MarJong/ECCO-Uhr/Fertigungsdaten/Adapterplatine V1_0.png

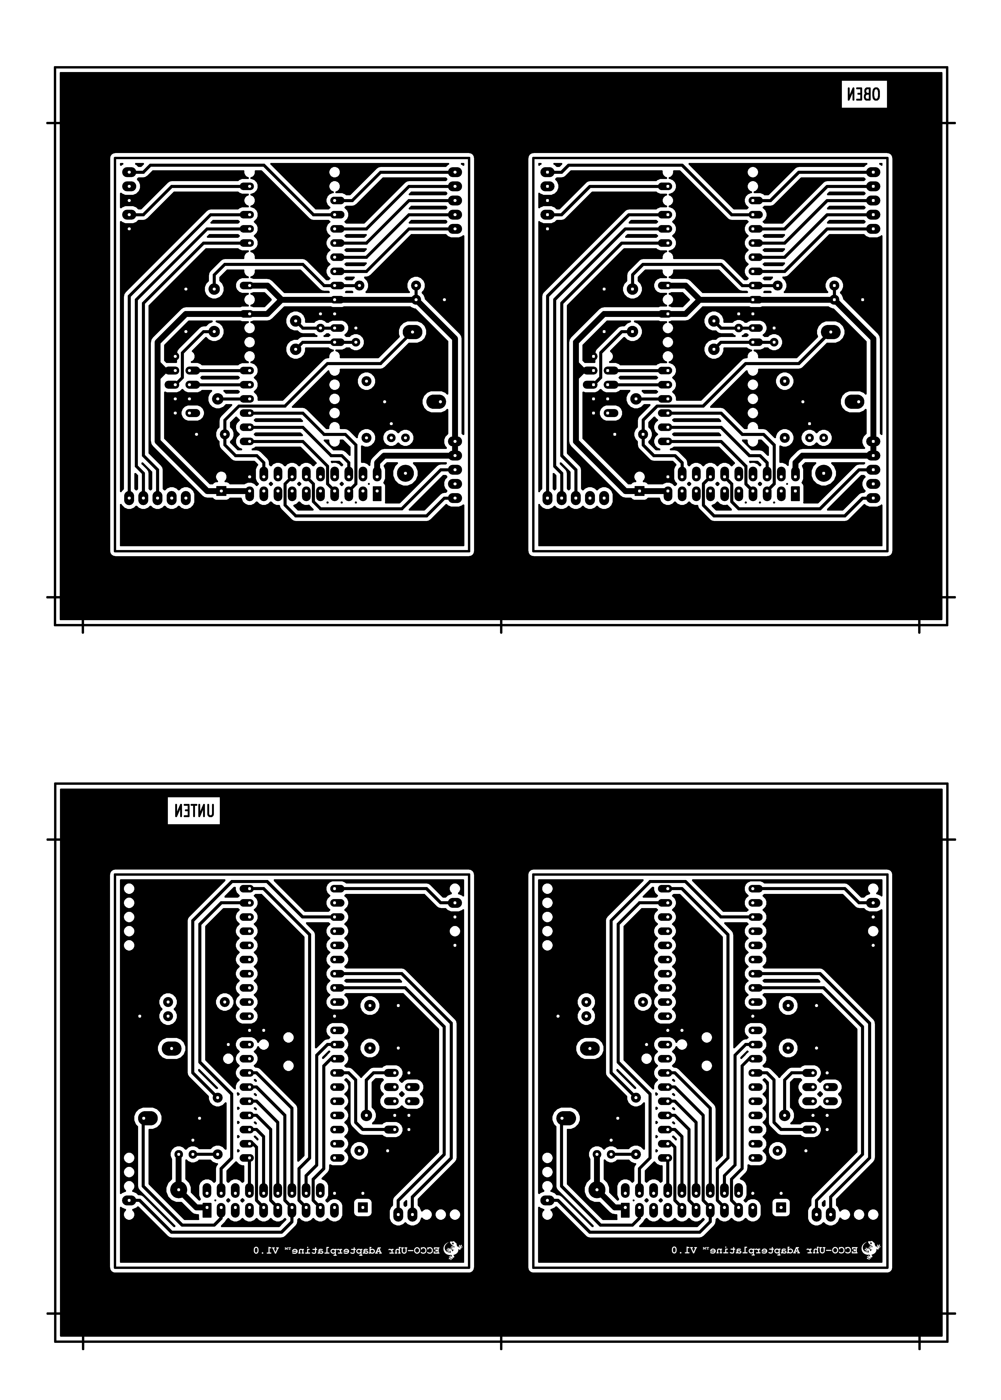
Fertigungsdaten/Adapterplatine V1_0.png
