MarJong/ECCO-Uhr/Fertigungsdaten/Bestueckung_Hauptplatine.png

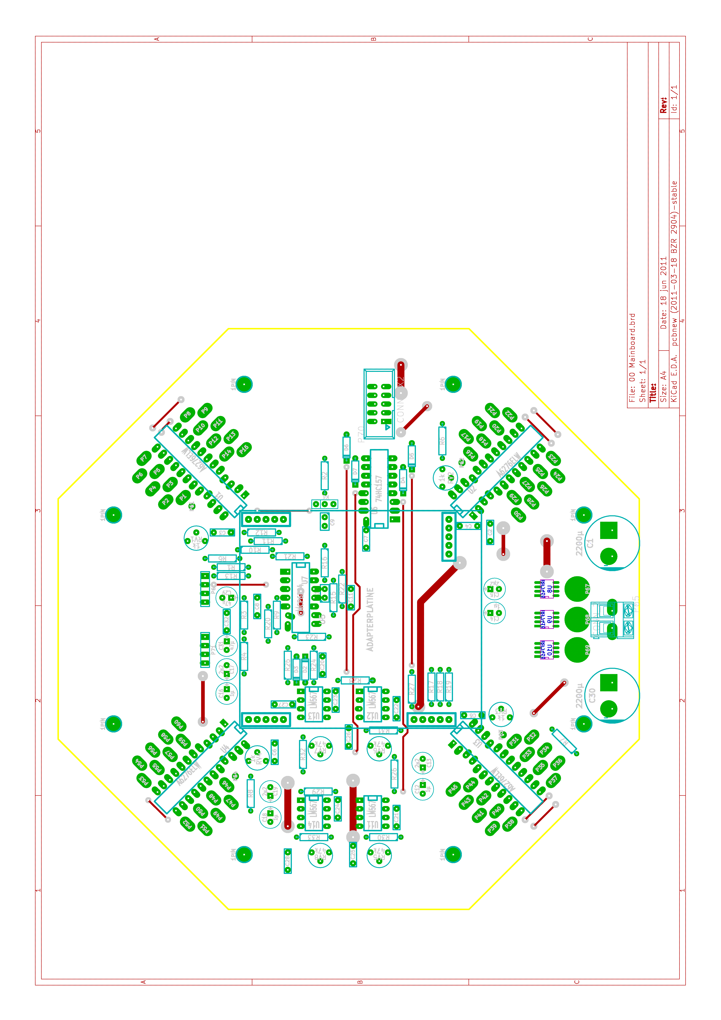
Fertigungsdaten/Bestueckung_Hauptplatine.png
