MarJong/ECCO-Uhr/Fertigungsdaten/Pinbelegung_Adapterplatine.png

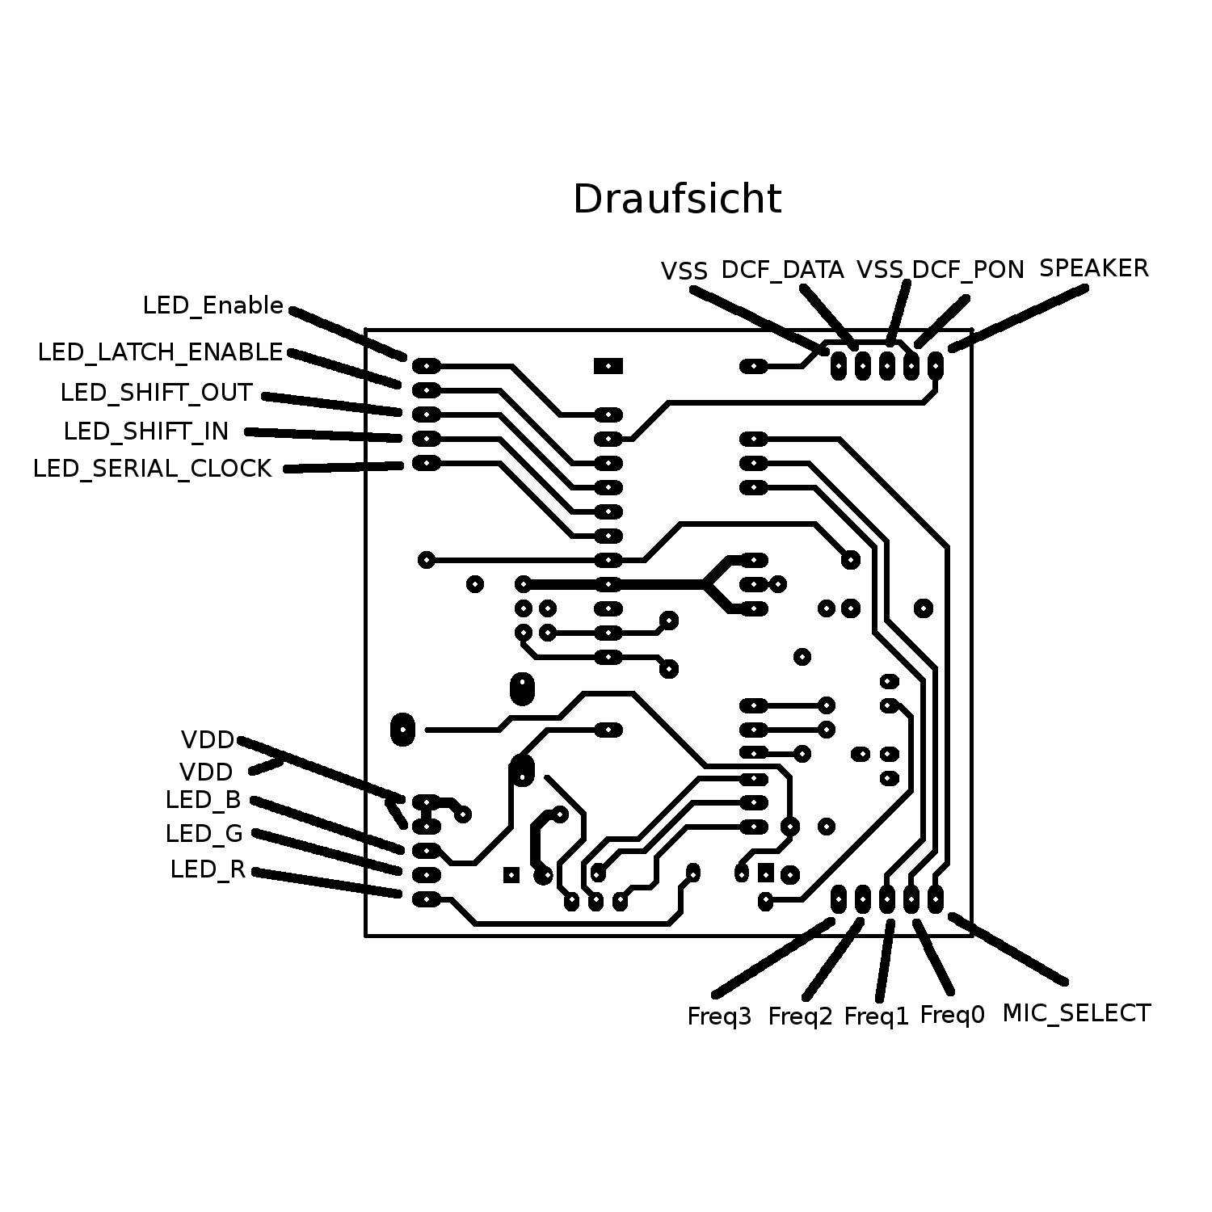
Fertigungsdaten/Pinbelegung_Adapterplatine.png
