MarJong/ECCO-Uhr/Fertigungsdaten/Pinbelegung_Mainboard.png

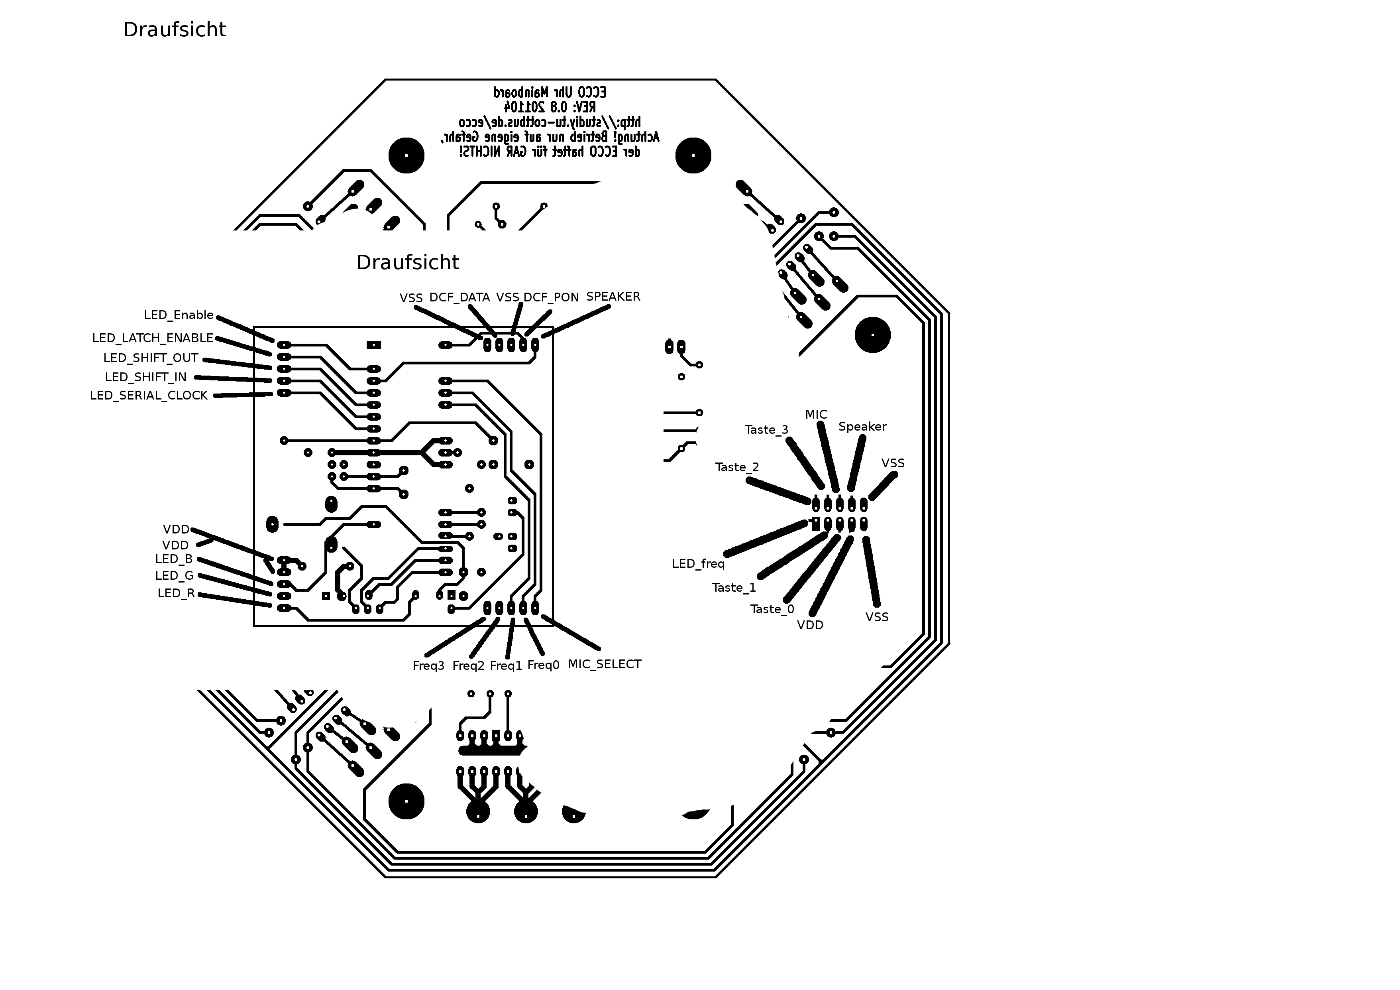
Fertigungsdaten/Pinbelegung_Mainboard.png
