MarJong/ECCO-Uhr/Fertigungsdaten/Schablone_Mainboard_V1.png

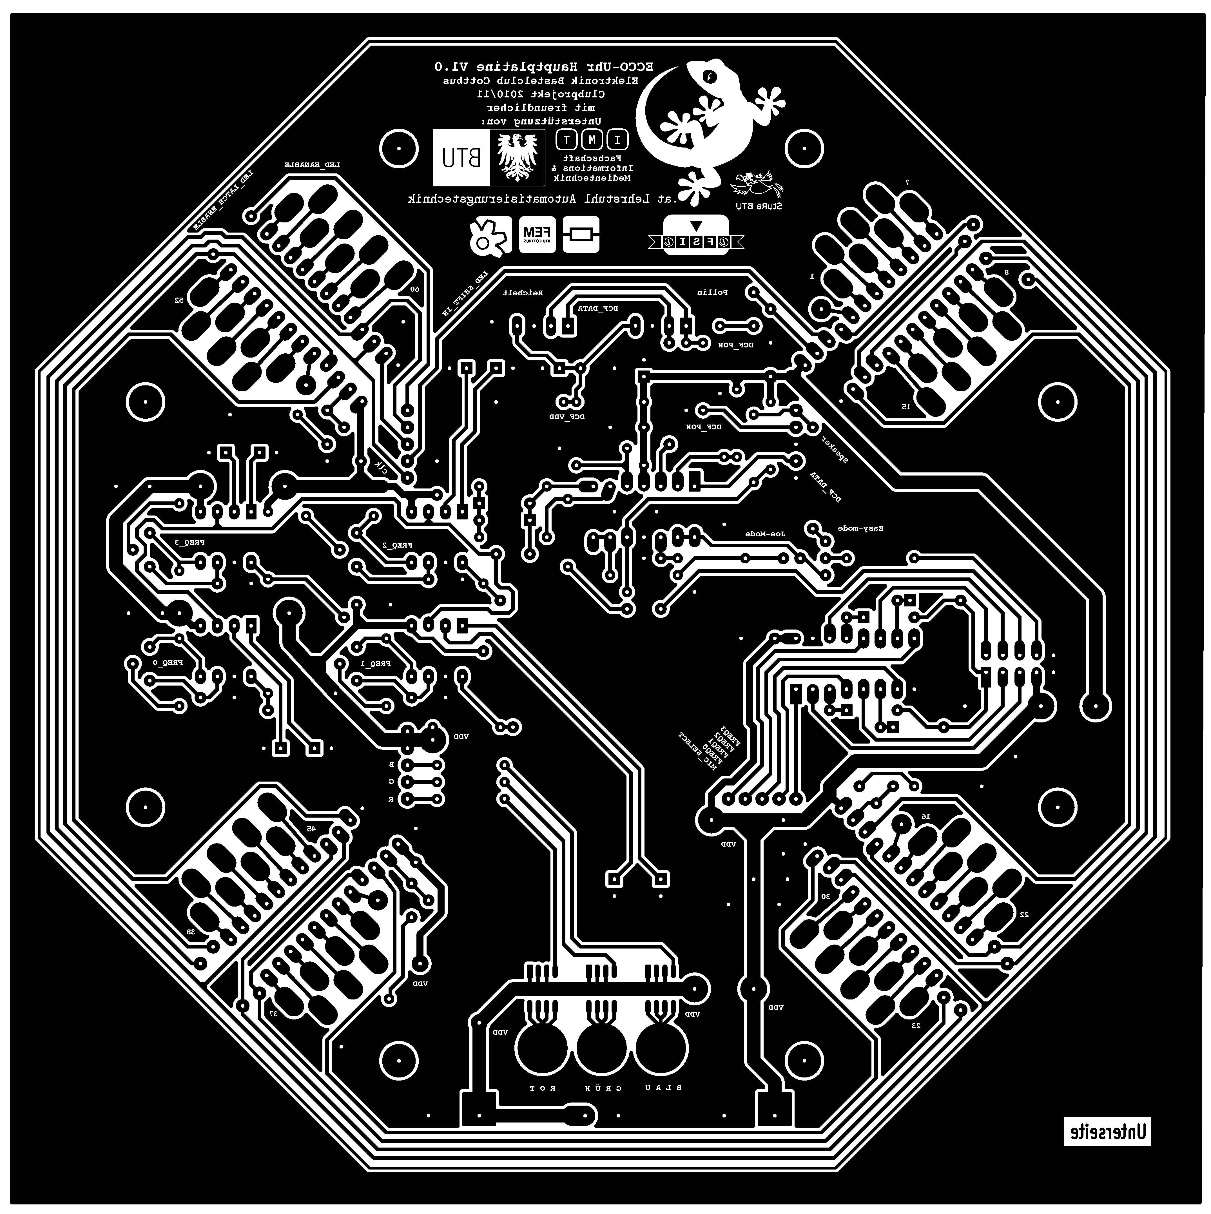
Fertigungsdaten/Schablone_Mainboard_V1.png
