MarJong/ECCO-Uhr/Fertigungsdaten/Schematic_Adapterplatine.png

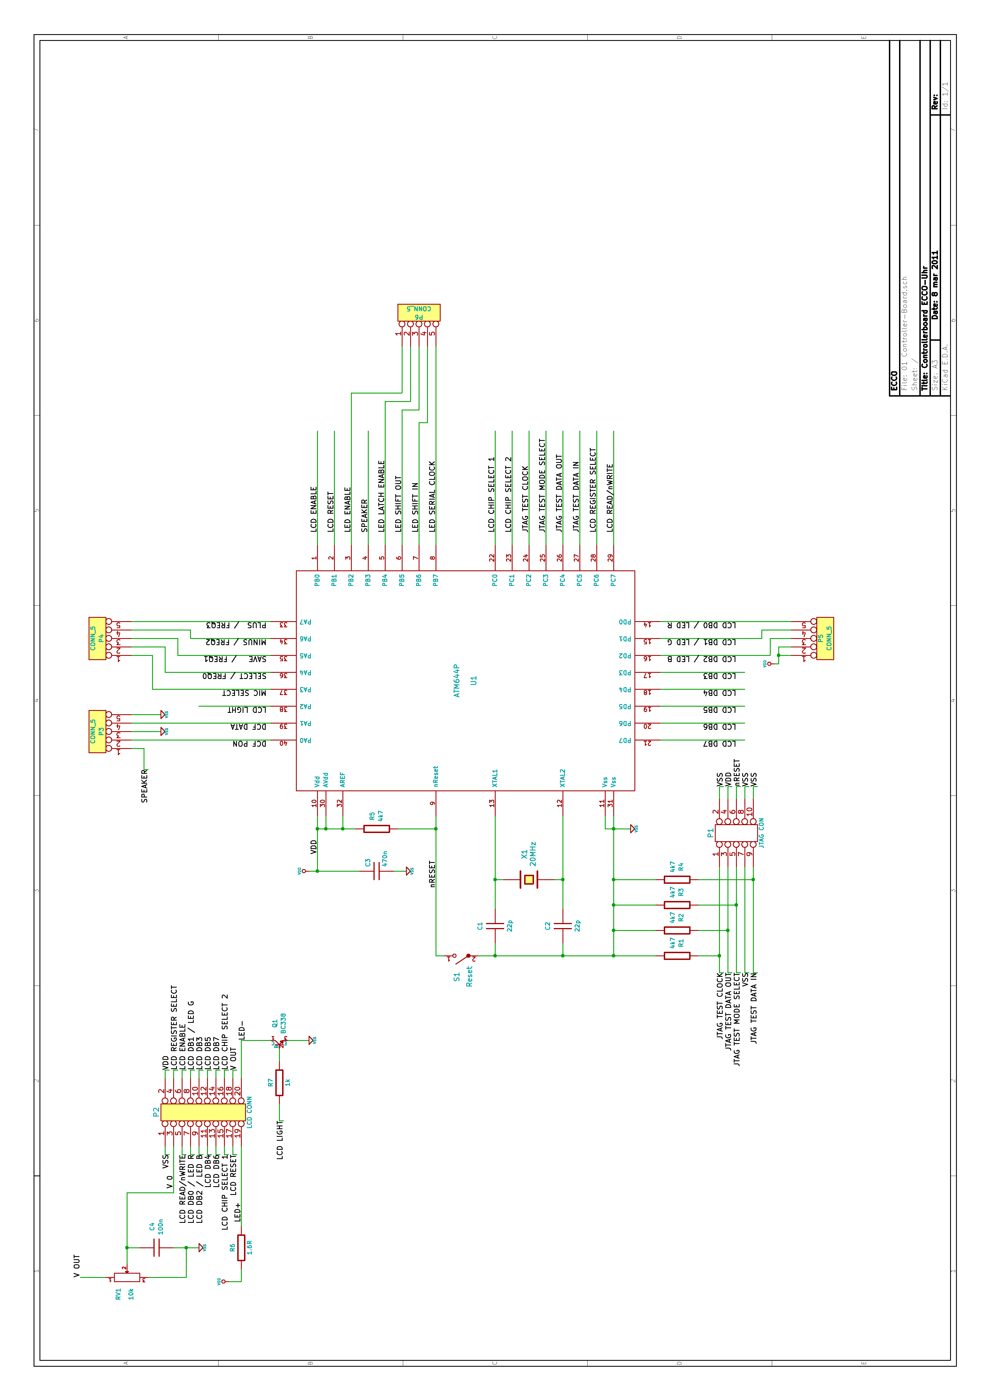
Fertigungsdaten/Schematic_Adapterplatine.png
