MarJong/ECCO-Uhr/Fertigungsdaten/Schematic_IOPlatine.png

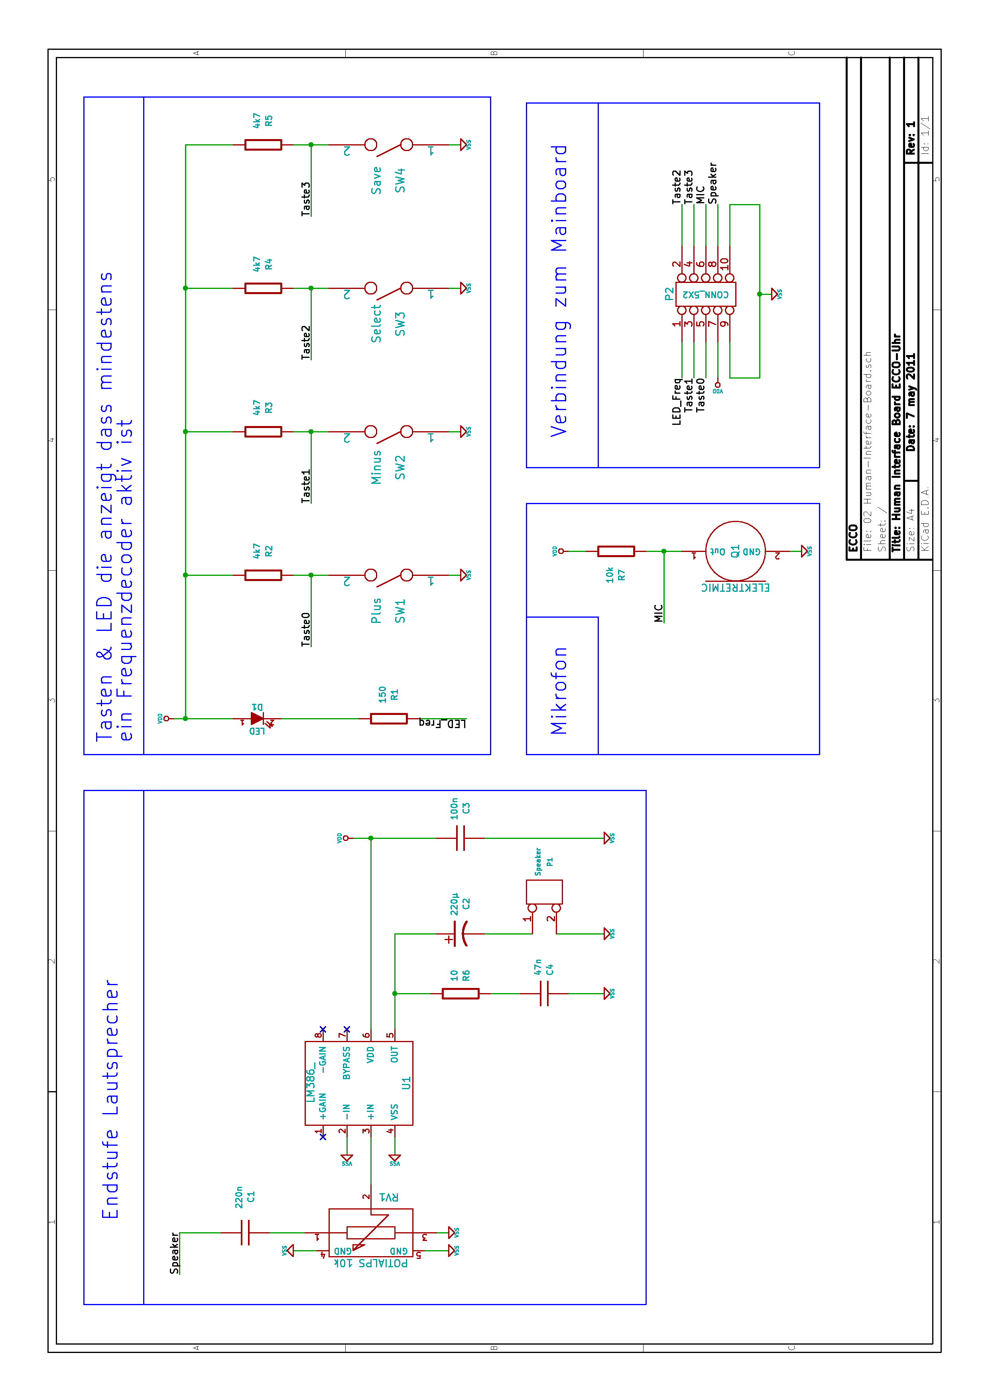
Fertigungsdaten/Schematic_IOPlatine.png
