MarJong/ECCO-Uhr/Fertigungsdaten/Schematic_Mainboard.png

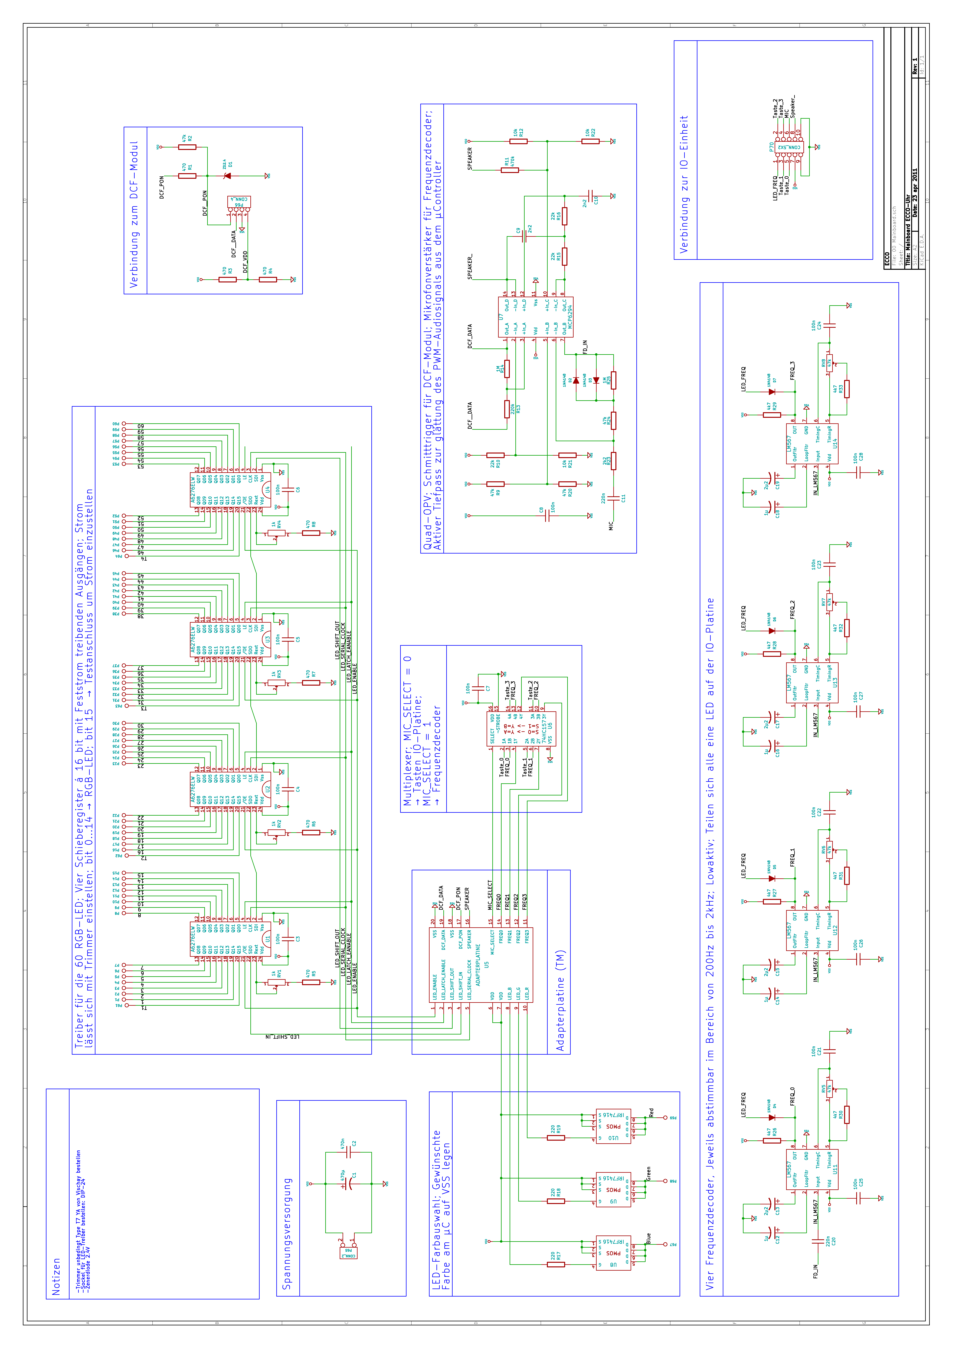
Fertigungsdaten/Schematic_Mainboard.png
