MarJong/ECCO-Uhr/Fertigungsdaten/Sponsoren.png

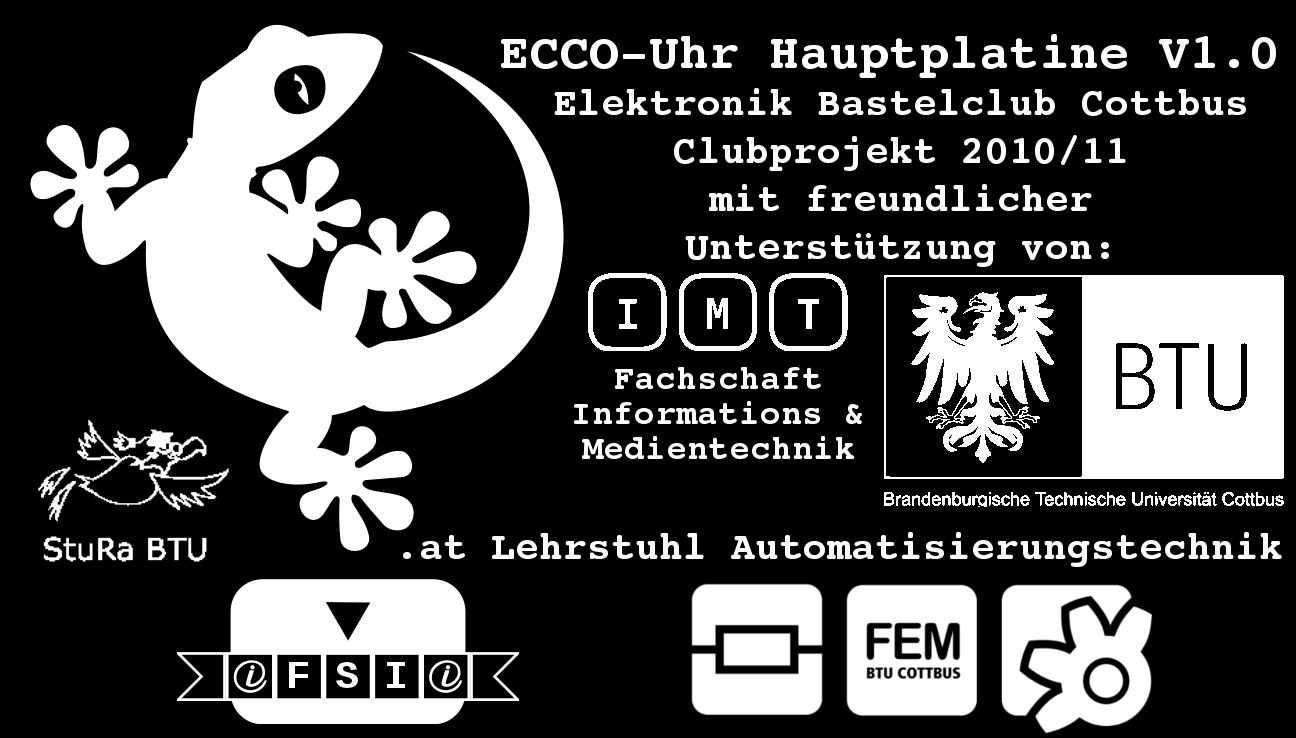
Fertigungsdaten/Sponsoren.png
