MarJong/ECCO-Uhr/Hardware/00 Mainboard-Back.png

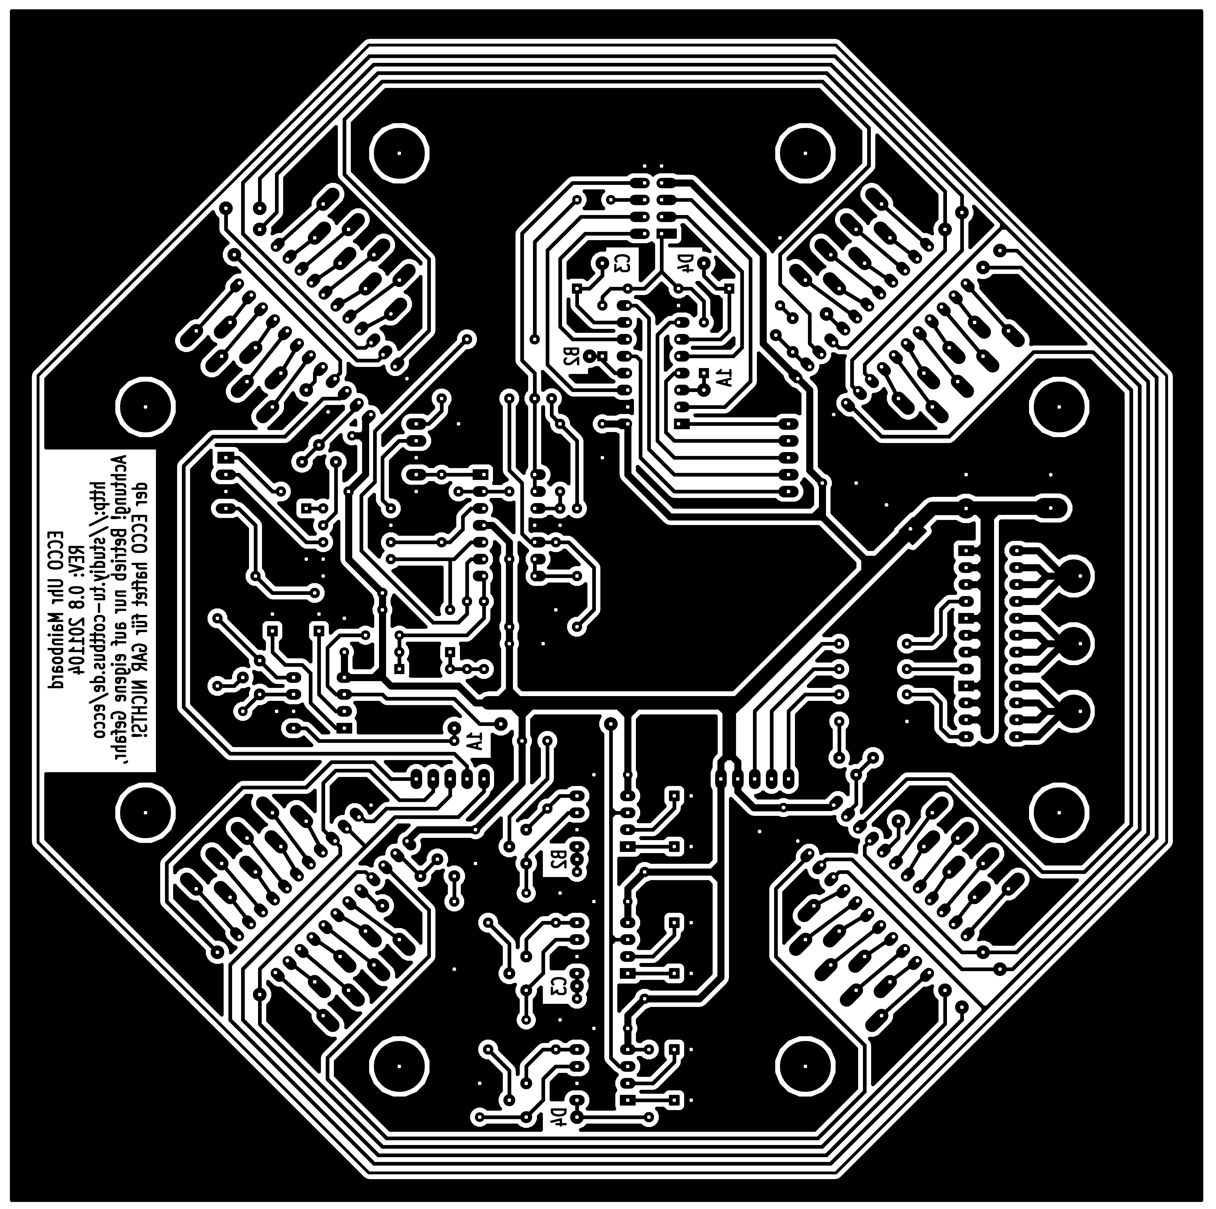
Hardware/00 Mainboard-Back.png
