MarJong/ECCO-Uhr/Hardware/00 Mainboard.png

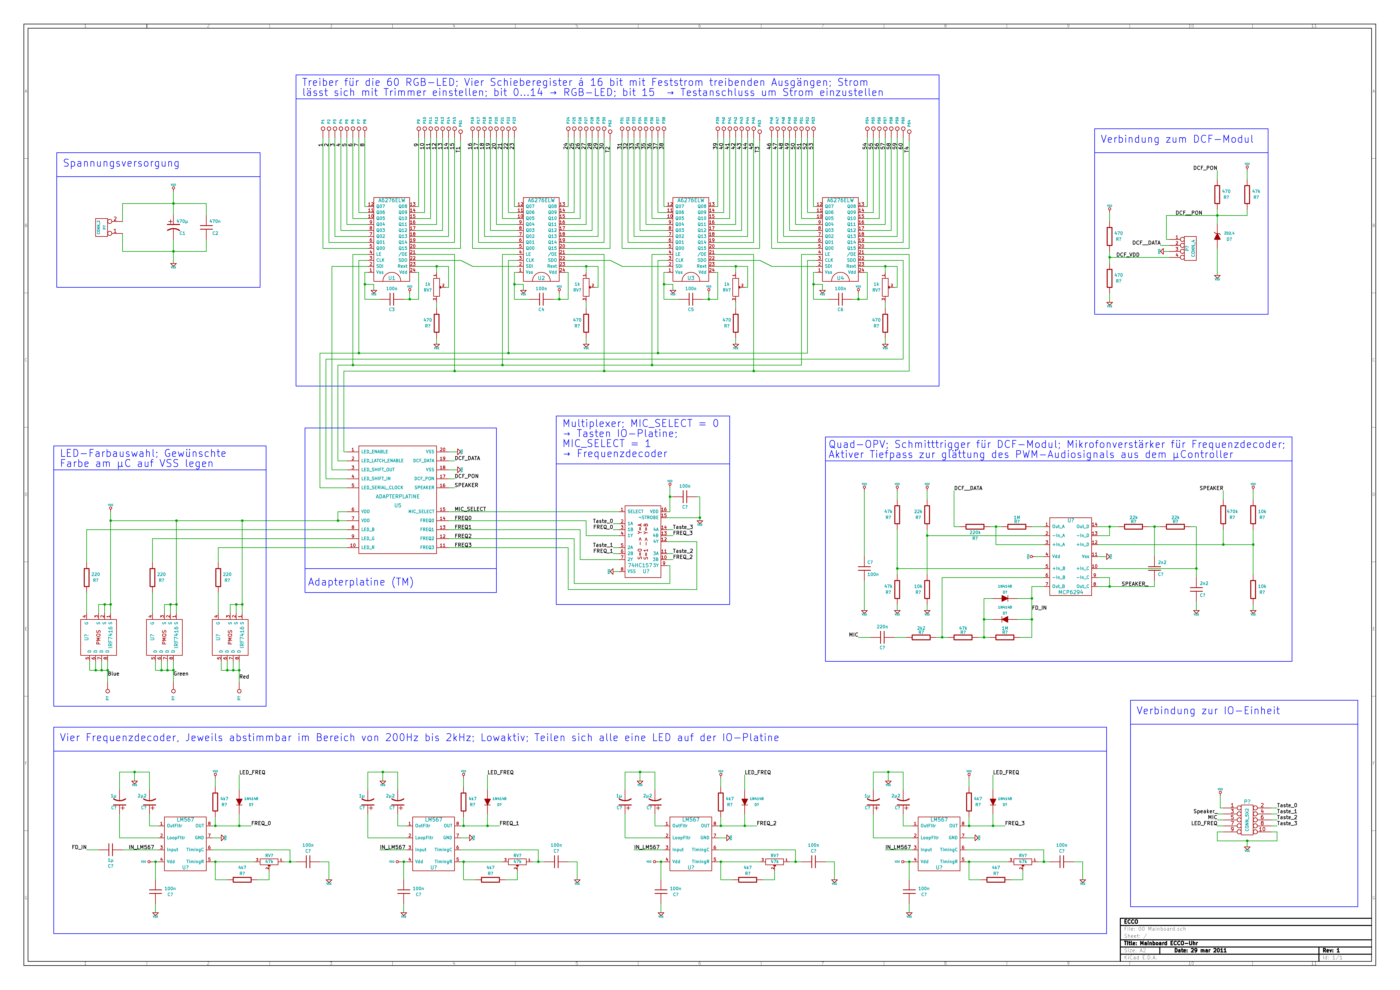
Hardware/00 Mainboard.png
