MarJong/ECCO-Uhr/Hardware/03 LED-Boards-Back.png

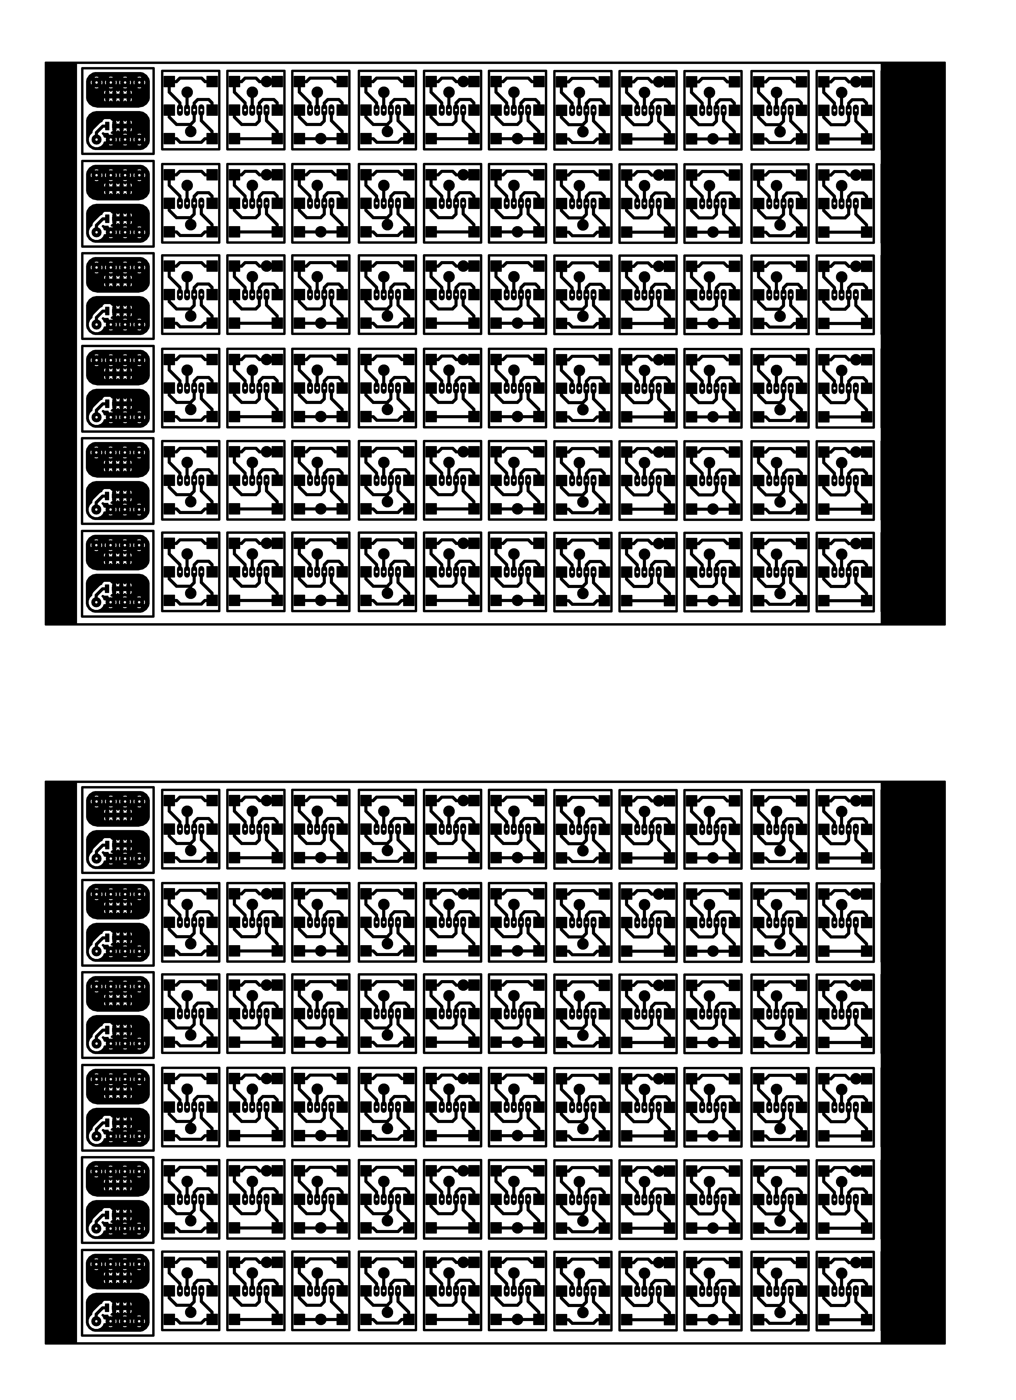
Hardware/03 LED-Boards-Back.png
