MarJong/ECCO-Uhr/Hardware/00 Mainboard Stückliste.pdf

Tabelle1

ref | value | footprint | Verfügbarkeit | Erledigt
C1 | 470µ | 5.08mm
C2 | 470n | 5.08mm
C3 | 100n | 5.08mm
C4 | 100n | 5.08mm
C5 | 100n | 5.08mm
C6 | 100n | 5.08mm
C7 | 100n | 5.08mm
C8 | 100n | 5.08mm
C9 | 2n2 | 2.54mm
C10 | 2n2 | 2.54mm
C11 | 220n | 5.08mm
C12 | 1µ | 5.08mm
C13 | 2µ2 | 2.54mm
C14 | 1µ | 2.54mm
C15 | 2µ2 | 2.54mm
C16 | 1µ | 5.54mm
C17 | 2µ2 | 5.54mm
C18 | 1µ | 5.54mm
C19 | 2µ2 | 5.54mm
C20 | 1µ | 5.54mm
C21 | 100n | 5.08mm
C22 | 100n | 5.08mm
C23 | 100n | 5.08mm
C24 | 100n | 5.08mm
C25 | 100n | 5.08mm
C26 | 100n | 5.08mm
C27 | 100n | 5.08mm
C28 | 100n | 5.08mm
D1 | ZD2.4 | DO-35
D2 | 1N4148 | DO-34
D3 | 1N4148 | DO-33
D4 | 1N4148 | DO-32
D5 | 1N4148 | DO-31
D6 | 1N4148 | DO-30
D7 | 1N4148 | DO-29
P61 | CONN_1 | Lötnagel
P62 | CONN_1 | Lötnagel
P63 | CONN_1 | Lötnagel
P64 | CONN_1 | Lötnagel
P65 | CONN_2 | AKL 5,08mm
P66 | CONN_4 | Buchsenleiste
P70 | CONN_5X2 | Wannenstecker gerade
R1 | 470 | Metall 0.6W
R2 | 47k | Metall 0.6W
R3 | 470 | Metall 0.6W
R4 | 470 | Metall 0.6W
R5 | 470 | Metall 0.6W
R6 | 470 | Metall 0.6W
R7 | 470 | Metall 0.6W

Tabelle1

ref | value | footprint | Verfügbarkeit | Erledigt
R8 | 470 | Metall 0.6W
R9 | 47k | Metall 0.6W
R10 | 22k | Metall 0.6W
R11 | 470k | Metall 0.6W
R12 | 10k | Metall 0.6W
R13 | 220k | Metall 0.6W
R14 | 1M | Metall 0.6W
R15 | 22k | Metall 0.6W
R16 | 22k | Metall 0.6W
R17 | 220 | Metall 0.6W
R18 | 220 | Metall 0.6W
R19 | 220 | Metall 0.6W
R20 | 47k | Metall 0.6W
R21 | 10k | Metall 0.6W
R22 | 10k | Metall 0.6W
R23 | 2k2 | Metall 0.6W
R24 | 47k | Metall 0.6W
R25 | 1M | Metall 0.6W
R26 | 4k7 | Metall 0.6W
R27 | 4k7 | Metall 0.6W
R28 | 4k7 | Metall 0.6W
R29 | 4k7 | Metall 0.6W
R30 | 4k7 | Metall 0.6W
R31 | 4k7 | Metall 0.6W
R32 | 4k7 | Metall 0.6W
R33 | 4k7 | Metall 0.6W
RV1 | 1k | Metall 0.6W
RV2 | 1k | Metall 0.6W
RV3 | 1k | Metall 0.6W
RV4 | 1k | Metall 0.6W
RV5 | 47k | Metall 0.6W
RV6 | 47k | Metall 0.6W
RV7 | 47k | Metall 0.6W
RV8 | 47k | Metall 0.6W
U1 | A6276ELW | DIL-24
U2 | A6276ELW | DIL-24
U3 | A6276ELW | DIL-24
U4 | A6276ELW | DIL-24
U5 | ADAPTERPLATINE | 4*5er Buchsenleisten
U6 | 74HC157 | DIL-16
U7 | MCP6294 | DIL-14
U8 | IRF7416 | 2*12er Buchsenleisten
U9 | IRF7416
U10 | IRF7416
U11 | LM567 | DIL-8
U12 | LM567 | DIL-8
U13 | LM567 | DIL-8
U14 | LM567 | DIL-8
