MarJong/ECCO-Uhr/Fertigungsdaten/Materialbedarf_Mainboard.ods

 | Designator | Package | Qty | Designation | Verfügbar | Erledigt
0 | Platine (incl. Aller Brücken!) | 1,5mm Epoxid | 1 | Hauptplatine
1 | U8, U9, U10 | SO8E | 3 | IRF7416
2 | U11, U12, U13, U14 | DIP-8 | 4 | LM567 + Sockel
3 | U1, U2, U3, U4 | DIP-24 | 4 | A6276ELW + Sockel
4 | U6 | DIP-16 | 1 | 74HC157 + Sockel
5 | U7 | DIP-14 | 1 | MCP6294 + Sockel
6 | K1 | Stiftleiste + Jumper | 1 | CONN_3
7 | U5 | Adapterplatine_1.0 | 1 | 4*5er Buchsenleiste
8 | P61, P62, P63, P64 | Lötnagel | 7 | CONN_1
9 | P65 | AKL 5.08mm | 1 | CONN_2
10 | P70 | Wannenstecker 5*2 | 1 | CONN_5X2
11 | P66, P71 | Stiftleiste 4x1 | 1 | Reichelt, Pollin (DCF)
12 | RV1, RV2, RV3, RV4 | VISHAY T7YA | 4 | 1k
13 | RV5, RV6, RV7, RV8 | VISHAY T7YA | 4 | 47k
14 | R17, R18, R19 | 10.16mm | 3 | 220
15 | R3 | 10.16mm | 1 | 330
16 | R4, R5, R6, R7, R8 | 10.16mm | 5 | 470
17 | R23 | 10.16mm | 1 | 2k2
18 | R1 | 10.16mm | 1 | 3k3
19 | R13, R26, R27, R28, R29, R31 | 10.16mm | 6 | 4k7
20 | R12, R21, R22 | 10.16mm | 3 | 10k
21 | R10, R11, R15, R16, R30, R32, R33 | 10.16mm | 7 | 22k
22 | R9, R20, R24 | 10.16mm | 3 | 47k
24 | R2 | 10.16mm | 1 | 100k
25 | R25 | 10.16mm | 1 | 1M
26 | D2, D3, D4, D5, D6, D7 | 7.62mm | 6 | 1N4148
27 | C9, C10 | 2.54mm | 2 | 2n2
28 | C23, C24 | 5.08mm | 2 | 22n
29 | C21, C22 | 5.08mm | 2 | 47n
30 | C3, C4, C5, C6, C7, C8, C25, C26, C27, C28, C32 | 5.08mm | 11 | 100n
31 | C11 | 5.08mm | 1 | 220n
32 | C2 | 5.08mm | 1 | 470n
33 | C20 | 5.08mm | 1 | 1000n
34 | C12, C14, C16, C18 | 2.54mm | 4 | 1µ
35 | C13, C15, C17, C19 | 2.54mm | 4 | 2µ2
36 | C29, C31 | 2.54mm | 2 | 47µ
37 | C1, C30 | 7.62mm | 2 | 2200µ
38 | Schrauben & Abstandshalter | M3 | 8
