MarJong/ECCO-Uhr/Fertigungsdaten/AdapterplatineStueckliste.ods

Id | Designator | Package | Quantity | Designation | Vorhanden | Erledigt
1 | R1 | R4-LARGE_PADS | 1 | 1k
2 | P3 | Wanne_5x2_HM | 1 | JTAG_CON
3 | P1 | Wanne_10x2_HM | 1 | LCD_CONN
4 | Q1 | TO92-123 | 1 | BC338
5 | S1 | SW_PUSH_SMALL | 1 | Reset
6 | R2 | R4-LARGE_PADS | 1 | 4k7
7 | RV1 | PT15_HM_PIHER | 1 | 10k
8 | P4,P5,P6,P7 | pin_strip_5 | 4 | CONN_5
9 | X1 | HC-49V | 1 | 20MHz
10 | U1 | DIP-40__600_ELL | 1 | ATM644P
11 | C4 | CP_5x11mm | 1 | 100µ
12 | C1 | C2 | 1 | 100n
13 | C5 | C2 | 1 | 470n
14 | C2,C3 | C1 | 2 | 22p
