MarJong/ECCO-Uhr/Hardware/01 Controller-Board-stückliste.ods

ref | value
C1 | 22p
C2 | 22p
C3 | 470n
C4 | 100n
P1 | JTAG CON
P2 | LCD CONN
P3 | CONN_5
P4 | CONN_5
P5 | CONN_5
P6 | CONN_5
Q1 | BC338
R1 | 4k7
R2 | 4k7
R3 | 4k7
R4 | 4k7
R5 | 4k7
R6 | 1.6R
R7 | 1k
RV1 | 10k
S1 | Reset
U1 | ATM644P
X1 | 20MHz
