MarJong/ECCO-Uhr/Hardware/00 Mainboard.ods

Id | Designator | Package | Quantity | Designation | Supplier and ref
1 | P69,P68,P67,P61,P64,P63,P62 | 1pin | 7 | CONN_1
2 | P65 | AK300-2 | 1 | CONN_2
3 | C10,C9 | C1 | 2 | 2n2
4 | C19,C17,C15,C13 | C1V7 | 4 | 2µ2
5 | C18,C16,C14,C12 | C1V7 | 4 | 1µ
6 | C28,C27,C26,C25,C24,C23,C22,C21,C8,C7,C6,C5,C4,C3 | C2 | 14 | 100n
7 | C11,C20 | C2 | 2 | 220n
8 | C2 | C2 | 1 | 470n
9 | D7,D6,D5,D4,D3,D2 | D3 | 6 | 1N4148
10 | D1 | D3 | 1 | ZD2.4
11 | U7 | DIP-14__300_ELL | 1 | MCP6294
12 | U6 | DIP-16__300_ELL | 1 | 74HC157
13 | U4,U3,U2,U1 | DIP-24__300_ELL | 4 | A6276ELW
14 | U14,U13,U12,U11 | DIP-8__300_ELL | 4 | LM567
15 | U10,U9,U8 | DIP-8__300_ELL | 3 | IRF7416
16 | P66 | PIN_ARRAY_4x1 | 1 | CONN_4
17 | RV8,RV7,RV6,RV5 | RV2 | 4 | 47k
18 | RV4,RV3,RV2,RV1 | RV2 | 4 | 1k
19 | P70 | VASCH5x2 | 1 | CONN_5X2
20 | U5 | Adapterplatine_0.9 | 1 | ADAPTERPLATINE
21 | P1...P60 | 1pin_smd | 60 | CONN_1
22 | C1 | C2V10 | 1 | 470µ
23 | R7,R8,R5,R6,R1,R4,R3 | R4 | 7 | 470
24 | R19,R18,R17 | R4 | 3 | 220
25 | R14,R25 | R4 | 2 | 1M
26 | R13 | R4 | 1 | 220k
27 | R15,R16,R10 | R4 | 3 | 22k
28 | R22,R12,R21 | R4 | 3 | 10k
29 | R11 | R4 | 1 | 470k
30 | R24,R20,R9,R2 | R4 | 4 | 47k
31 | R30,R26,R27,R31,R28,R32,R29,R33 | R4 | 8 | 4k7
32 | R23 | R4 | 1 | 2k2
33 | 1PIN,1PIN,1PIN,1PIN,1PIN,1PIN,1PIN,1PIN | 1pin | 8 | P***
