MarJong/ECCO-Uhr/Fertigungsdaten/Frontplatte_A3.pdf

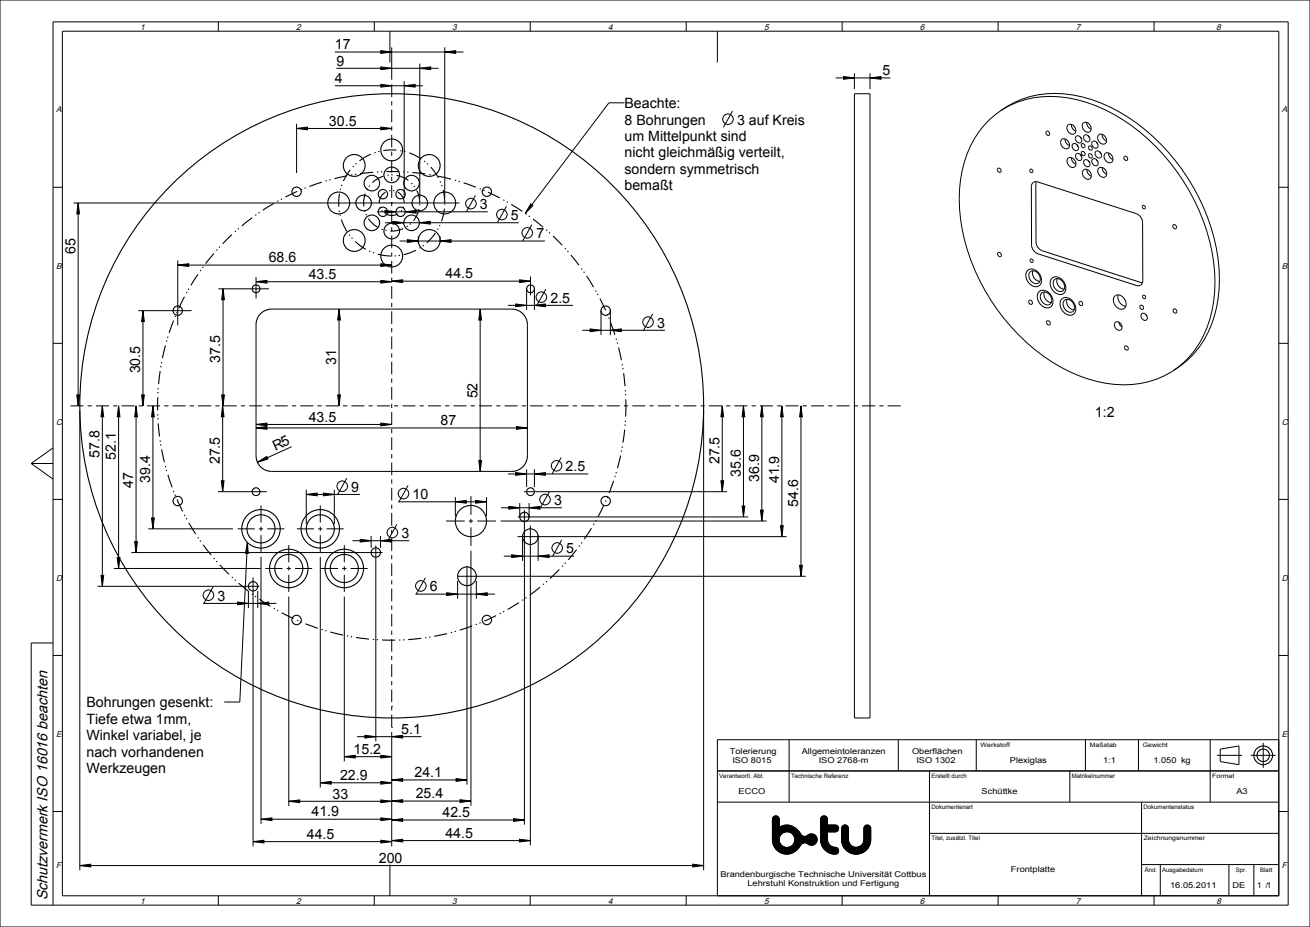
[picture p13: page 1]
Dokumentenart; Dokumentenstatus; 8 Bohrungen; 3 auf Kreis

Beachte:
um Mittelpunkt sind
nicht gleichmäßig verteilt,
sondern symmetrisch
bemaßt

Schutzvermerk ISO 16016 beachten
Bohrungen gesenkt:
Tiefe etwa 1mm,
Winkel variabel, je
nach vorhandenen
Werkzeugen

Tolerierung ISO 8015 | Allgemeintoleranzen ISO 2768-m | Oberflächen ISO 1302 | Werkstoff Plexiglas | Maßstab 1:1 | Gewicht 1.050 kg

Verantwortl. Abt. ECCO | Technische Referenz | Erstellt durch Schüttke | Matrikelnummer | Format A3

Titel, zusätzl. Titel Frontplatte Brandenburgische Technische Universität Cottbus | Zeichnungsnummer

Änd. | Ausgabedatum 16.05.2011 | Spr. DE | Blatt 1 /1

Lehrstuhl Konstruktion und Fertigung
