MarJong/ECCO-Uhr/Fertigungsdaten/frontplatte_einfach.pdf

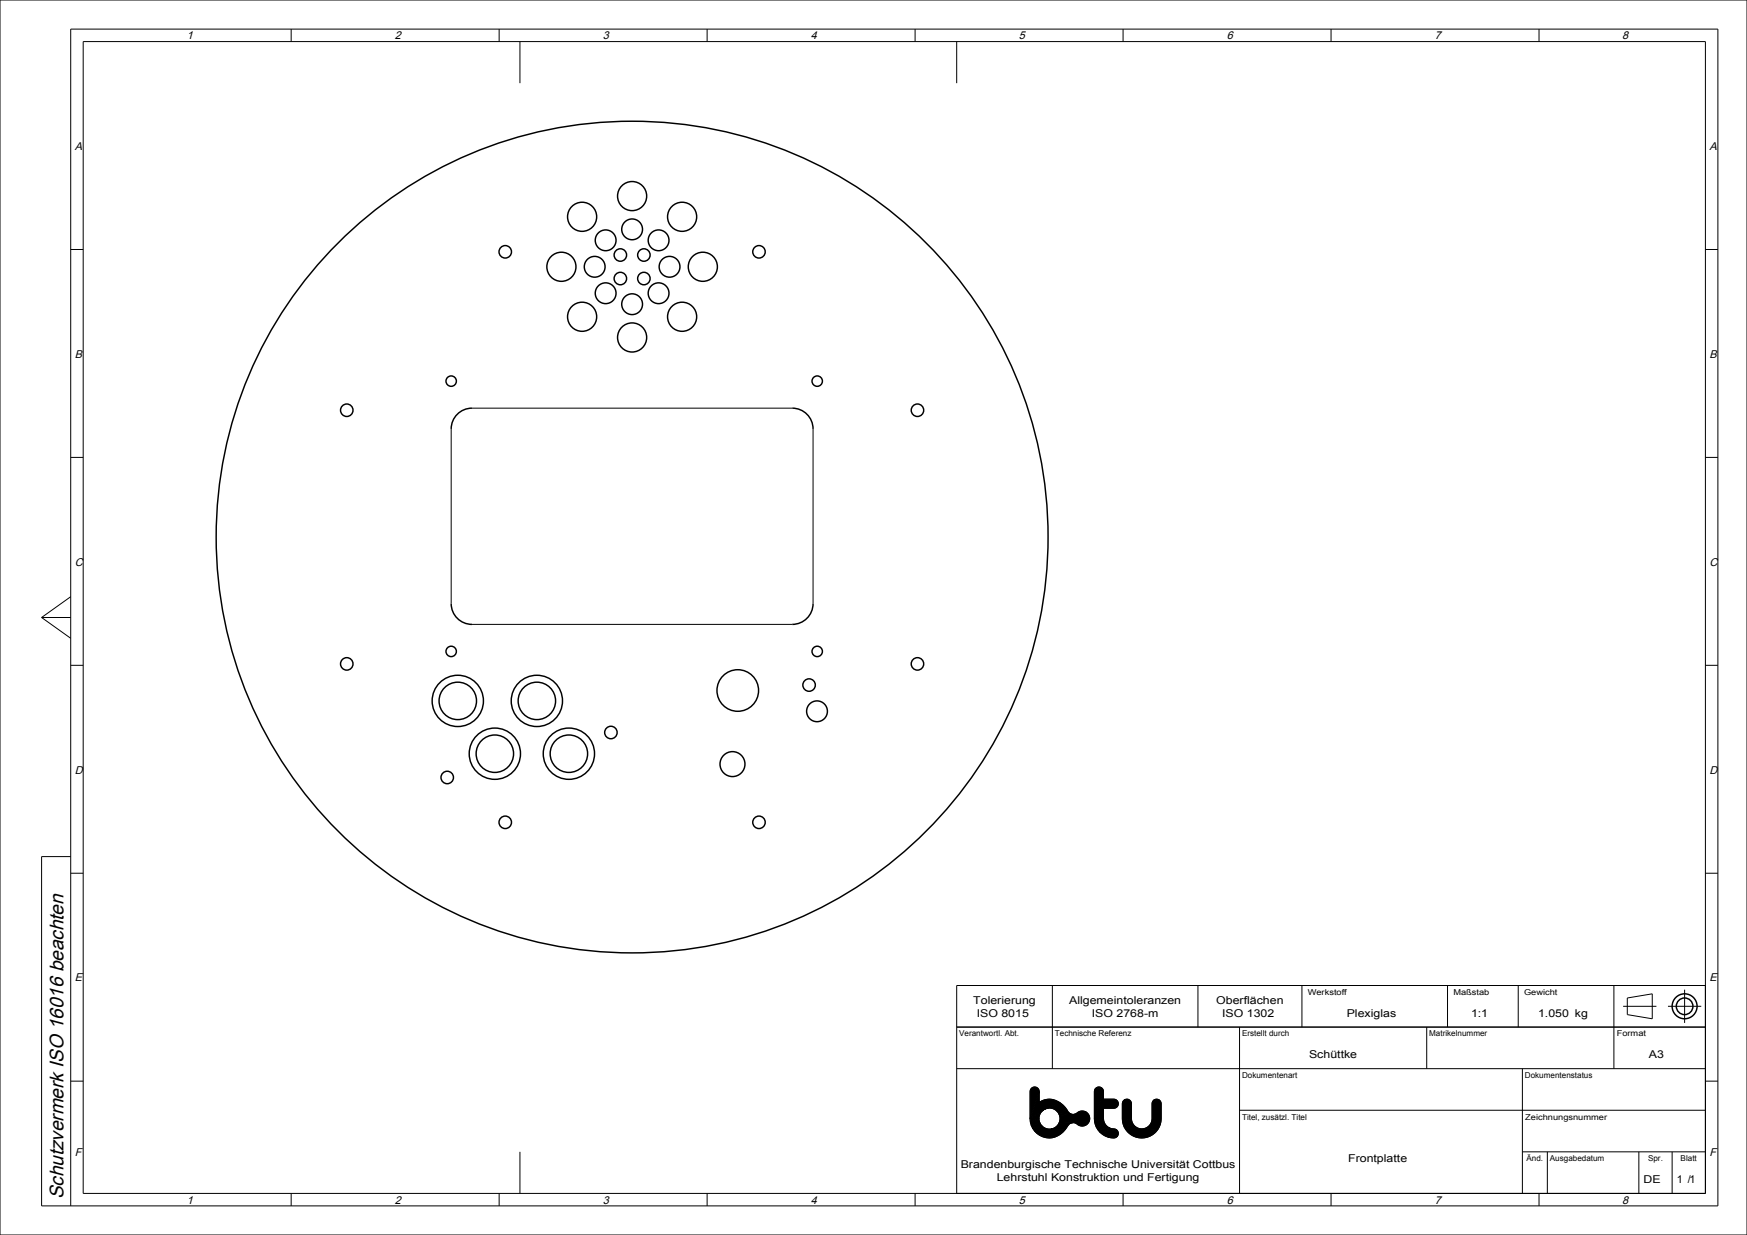
[picture p14: page 1]

Schutzvermerk ISO 16016 beachten

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

Verantwortl. Abt. | Technische Referenz | Erstellt durch Schüttke | Matrikelnummer | Format A3

Lehrstuhl Konstruktion und Fertigung | Dokumentenart | Dokumentenstatus

Titel, zusätzl. Titel Frontplatte Brandenburgische Technische Universität Cottbus | Zeichnungsnummer

Änd. | Ausgabedatum | Spr. DE | Blatt 1 /1
