MarJong/ECCO-Uhr/Fertigungsdaten/Ring_A4.pdf

A

2

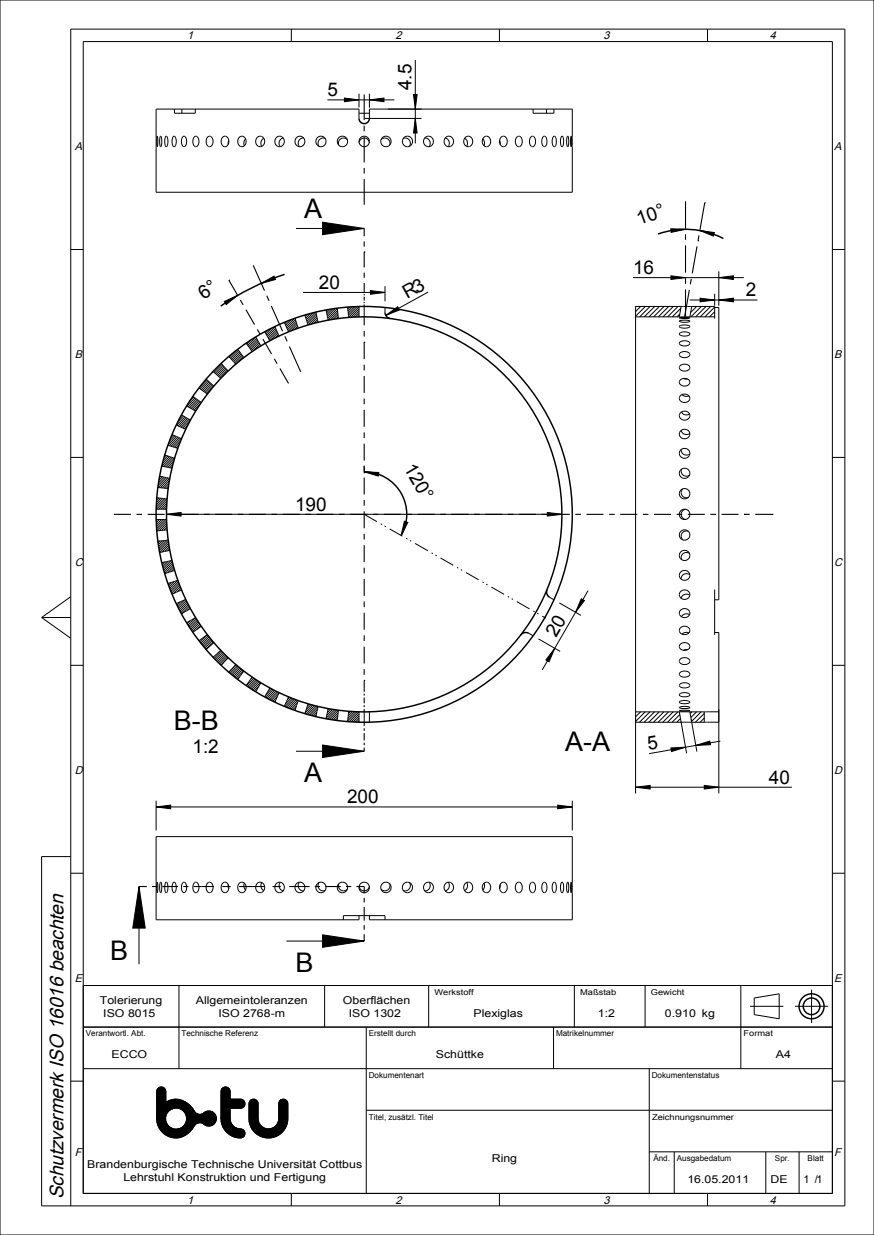
[picture p16: page 1]

Schutzvermerk ISO 16016 beachten

Tolerierung ISO 8015 | Allgemeintoleranzen ISO 2768-m | Oberflächen ISO 1302 | Werkstoff Plexiglas | Maßstab 1:2 | Gewicht 0.910 kg

Verantwortl. Abt. ECCO | Technische Referenz | Erstellt durch Schüttke | Matrikelnummer | Format A4

Lehrstuhl Konstruktion und Fertigung | Dokumentenart | Dokumentenstatus

Titel, zusätzl. Titel Ring Brandenburgische Technische Universität Cottbus | Zeichnungsnummer

Änd. | Ausgabedatum 16.05.2011 | Spr. DE | Blatt 1 /1
